keyboardio/keyboardio-kicad-libraries/(commit log)

2018-05-22 Add old keyboardio libraries, check in schematic and board configs
    [5050led.stp, DX07-midmount-2.stp, matias.stp]
2018-05-29 SChematic completed and BOM file is generated.
2018-06-01 Schematic is completed
2018-07-02 routed indicator LEDs. fixed schematic bugs with led placement
2018-07-02 Added 3D model for USB port
    [K3D-DX07B024JJ1-V1_JAE_Proprietary.STEP]
2018-07-27 add some kicad footprints for stabilizers
2018-09-21 clean up some footprints. remove unused versions
2018-09-26 add in some 3d models found on the internet. there are licensing issues
    [Stabilizer - close.STEP, Stabilizer - open.STEP, mx.step]
2018-10-02 about to reset track widths
2018-10-11 remove led from mx switch model
2018-10-11 start to add 3d keycap models
    [1x1R1.step, 1x1R2.step, 1x1R3.step, 1x1R4.step]
2018-10-13 add -some- of the default MX keycap step files
    [1x1.25R1.step, 1x1.25R2.step, 1x1.5R1.step, 1x1.5R2.step, 1x1.75R1.step, 1x1.75R2.step, 1x1.75R3.step, 1x2R1.step]
2018-10-19 import 3D models for Kailh sockets and 3528 LEDs from Dygma
    [KaihlSocket_1511-CONN-170206_ASM_ASM_3_ASM__ASM.STEP, LED_RGB_3528-4RGB-10026.step]
2018-10-20 Correct the name of the 3528 RGB LED
2019-02-21 check in some of our shared parts
    [TL3315NFxxxQ.stp]
2019-02-24 plot an icsp connector. switch to bigger, through hole fps for kailh sockets
2019-02-28 Fix the new through-hole switch component to only have copper on one side, which isn't strictly correct
2019-03-29 add large-pads and through holes version of the Kailh Socket
2019-03-29 Teensy eeschema library cloned from https://github.com/XenGi/teensy_library (MIT license)
2019-03-29 Teensy footprint library cloned from https://github.com/XenGi/teensy.pretty
2019-03-29 Add footprint and library for Arduino Micro from https://github.com/adamf/arduino_micro_shield
2019-03-29 Add a choc socket. to our footprints
2019-04-03 Add Fusion PCBA footprints from Seeed's repo as of today
2019-04-09 Reorg our kicad libraries so they're less chaotic
    [5050led.stp, DX07-midmount-2.stp, K3D-DX07B024JJ1-V1_JAE_Proprietary.STEP, KaihlSocket_1511-CONN-170206_ASM_ASM_3_ASM__ASM.STEP, LED_RGB_3528-4RGB-10026.step, TL3315NFxxxQ.stp, matias.stp]
2019-04-09 reorg to match kicad standards
2019-04-10 fix path to kailh socket 3d
2019-04-17 clean up placement of 3d models on switch
2019-05-06 DX07B024JJ3.kicad_mod sourced from https://gitlab.com/XenGi/darling/tree/master
    MIT licensed per the repo
2019-06-01 Bump up the through-hole size for the Kailh socket cutout based on negative experience with SMT by $other-co
2019-06-01 Open up cutout size for RGB LED so the LED flush mounts even when the hole is drilled, rather than cut. We've previously had issues with holes having rounded corners and LEDs not sitting flush
2019-06-13 Update MX-KailhClip-1.00u-large-pads.kicad_mod
    Round the smd pads for the keyboard switch socket; make the hole size 3.05mm to better fit sockets
2019-06-13 Update PRTR5V0U2X.kicad_mod
    Add a 3d model for the PRTR5VOU2x
2019-07-04 The existing switch model wasn't quite tall enough above the PCB
2019-07-05 A centered version of the KiCad default MX switch
2019-07-17 Update MX-KailhClip-1.00u-large-pads.kicad_mod
    Tweak socket footprint based on phyiscal measurements.
    Slightly reduce (oversized) pad size for easier board routing.
2019-07-17 Update 3528 (6028) footprint based on dygma's experience
    Enlarge the cutout. twak padsizes
2019-07-18 Fix ground plane interconnect for thermal vias on issi
2019-07-27 Add a version of our 3528 that defaults to front-mounting (shining toward the back).
    this is mostly useful for the autobuilder, rather than breaking all the
    existing boards using the old fp
2019-09-10 No functional changes. Just clicking save in KiCad 6 nightly. Because I like pain
2019-09-10 Enlarge center hole to 4.1mm on recommendation of mfg
2019-09-10 move the outer edge in dwgs.user to 9.5mm and make the line thinner
2019-09-10 add a cross on cmts.user dead-center in the switch
2019-10-10 Switch to vendor's keyswitch model, which I believe to be correctly centered
2019-10-11 Switch 3d model was 0.05mm too close to the PCB
2019-11-11 Add a PJ-3200B TRRS footprint from https://github.com/ai03-2725/random-keyboard-parts.pretty
2019-11-11 First pass of a choc footprint
2019-11-11 Update PJ-3200B-4A.kicad_mod naming to match KiCad's AudioJack 4, link in 3d model
2019-11-21 SOICBite footprint from https://github.com/SimonMerrett/SOICbite/tree/master
2019-11-21 Check in some test footprints for alternate kailh switches
2019-11-27 rework crazy composite footprint to be less crazy
2019-11-30 A bunch of new Kailh footprints. Including a new "magic" composite footprint covering Choc, MX, MX Mini, X-Switch, and ALPS. This footprint is untested
2019-11-30 Simplify footprint to the outer dimensions of an MX switch and an X switch, which I believe is the biggest courtyard we could have.
2019-12-02 Add a 19mm square drawing around the switch to make it more understandable
2019-12-03 Remove some silkscreen that's only accurate for one fp type
2020-03-25 Updated footprint to make it easier to do automated SMD of sockets without paste leakage. Also to make it harder for a bent switch pin to intermittently work by shorting to the annular ring. These ch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
2021-08-11 Delete SW_Cherry_MX_1.00u_PCB-Centered.kicad_mod
    This was a case-collision with the "current" footprint.
2021-08-11 add footprint for correct pinout icsp test points
2021-08-11 Remove silkscreen lines from edge cuts on LEDs
2021-12-20 check in locally updated footprints
2022-01-01 Add other keycap sizes of the house-standard hotswap switches. (3D for caps is not redistributable, so not checked in)
2022-12-19 add some 3d for the Kailh switch fp
2023-12-12 Check in some new speculative keyswitch footprints
2024-02-21 Check in a whole bunch of footprint updates
